scottlecomte/LoRaLAN-WiFi-Gateway/enclosure/lid_print_female.stl

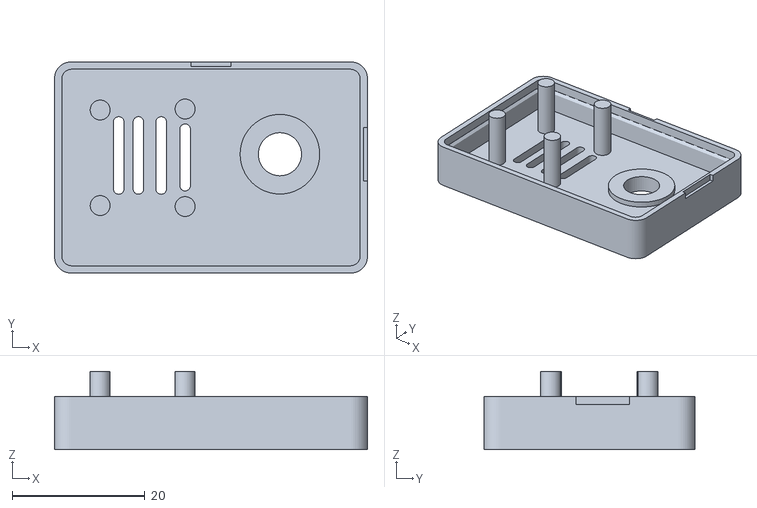
[picture p4: CAD file, 2026-11-04]
enclosure/lid_print_female.stl
47.2 x 31.8 x 11.8
