scottlecomte/LoRaLAN-WiFi-Gateway/enclosure/pin_test_coupon.stl

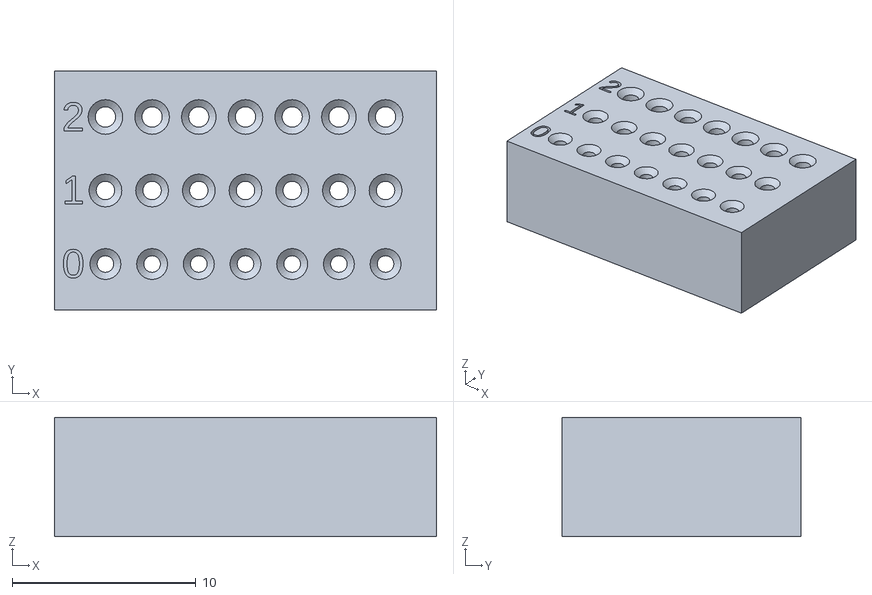
[picture p5: CAD file, 2026-11-04]
enclosure/pin_test_coupon.stl
20.8 x 13.0 x 6.50
