scottlecomte/LoRaLAN-WiFi-Gateway/enclosure/body_female.step

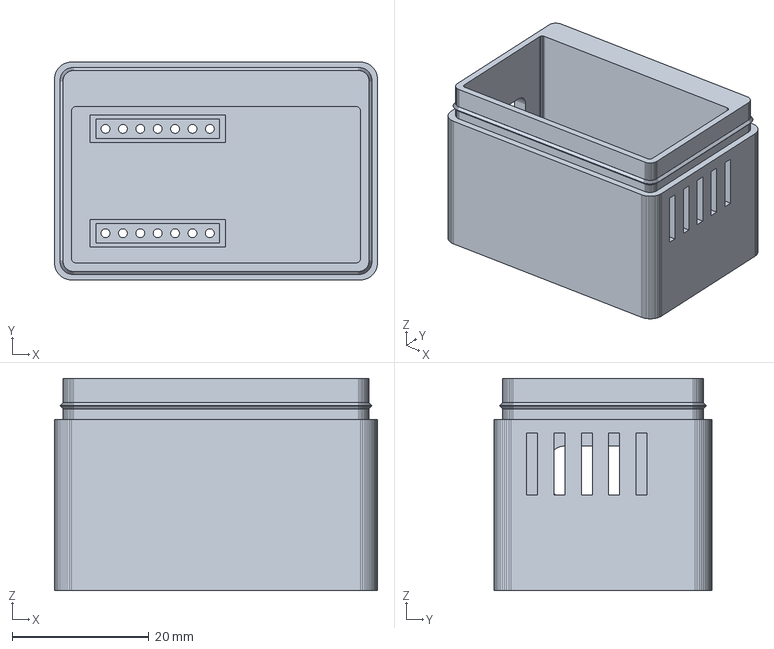
[picture p6: CAD file, 2026-11-04]
enclosure/body_female.step
47.2 x 31.8 x 31.0 mm
