scottlecomte/LoRaLAN-WiFi-Gateway/enclosure/body.step

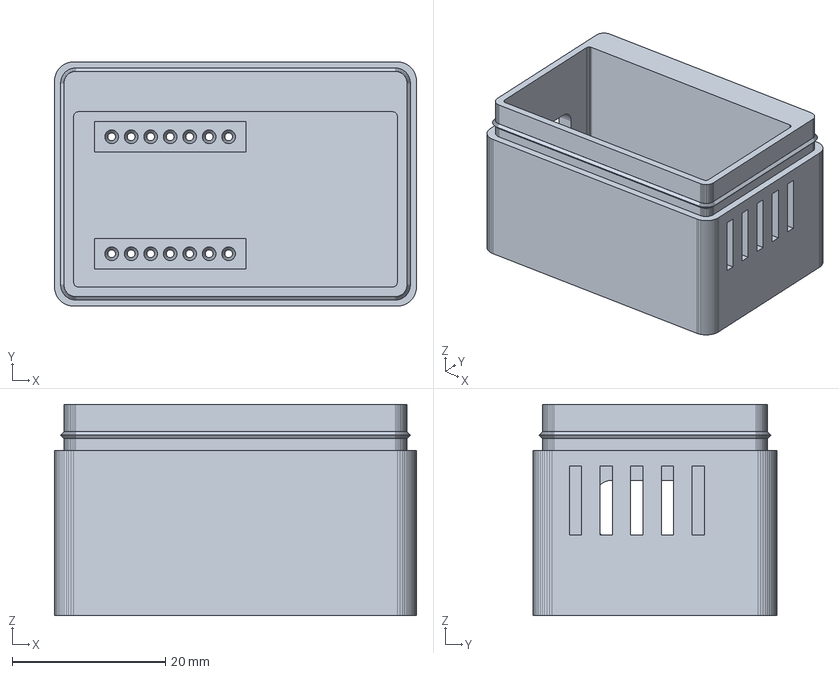
[picture p7: CAD file, 2026-11-04]
enclosure/body.step
47.2 x 31.8 x 27.5 mm
