scottlecomte/LoRaLAN-WiFi-Gateway/(list of files, cad)

Other CAD files:
enclosure/lid.step
enclosure/lid_print.stl
enclosure/body.stl
enclosure/body_female.stl
enclosure/lid.stl
